Vuddandareddyprathap/Hardware-Implementation-of-Multiplication-Through-Repeated-Addition/constr/constrs.xdc

# 50 MHz Onboard PL Crystal Clock
set_property PACKAGE_PIN U18 [get_ports clk]
set_property IOSTANDARD LVCMOS33 [get_ports clk]
create_clock -period 20.000 -name sys_clk [get_ports clk]

# PL Push Buttons (Active-High)
# SW5 -> Reset Button
set_property PACKAGE_PIN V15 [get_ports rst_btn]
set_property IOSTANDARD LVCMOS33 [get_ports rst_btn]

# SW7 -> Manual Clock Step Button
set_property PACKAGE_PIN W15 [get_ports clk_step_btn]
set_property IOSTANDARD LVCMOS33 [get_ports clk_step_btn]

# 4 Slide Switches (sw[0] = SW3, sw[1] = SW4, sw[2] = SW6, sw[3] = SW8)
set_property PACKAGE_PIN W19 [get_ports {sw[0]}]
set_property IOSTANDARD LVCMOS33 [get_ports {sw[0]}]

set_property PACKAGE_PIN N17 [get_ports {sw[1]}]
set_property IOSTANDARD LVCMOS33 [get_ports {sw[1]}]

set_property PACKAGE_PIN P18 [get_ports {sw[2]}]
set_property IOSTANDARD LVCMOS33 [get_ports {sw[2]}]

set_property PACKAGE_PIN P15 [get_ports {sw[3]}]
set_property IOSTANDARD LVCMOS33 [get_ports {sw[3]}]

# 4 Onboard User LEDs (D4 - D7)
set_property PACKAGE_PIN R16 [get_ports {led[0]}]
set_property IOSTANDARD LVCMOS33 [get_ports {led[0]}]

set_property PACKAGE_PIN R17 [get_ports {led[1]}]
set_property IOSTANDARD LVCMOS33 [get_ports {led[1]}]

set_property PACKAGE_PIN T17 [get_ports {led[2]}]
set_property IOSTANDARD LVCMOS33 [get_ports {led[2]}]

set_property PACKAGE_PIN R18 [get_ports {led[3]}]
set_property IOSTANDARD LVCMOS33 [get_ports {led[3]}]

# 4-Digit 7-Segment Display Anodes (Active-High through BC847 Transistors)
# an[0]=DIGIT4(right), an[1]=DIGIT3, an[2]=DIGIT2, an[3]=DIGIT1(left)
set_property PACKAGE_PIN U12 [get_ports {an[0]}]
set_property IOSTANDARD LVCMOS33 [get_ports {an[0]}]

set_property PACKAGE_PIN T12 [get_ports {an[1]}]
set_property IOSTANDARD LVCMOS33 [get_ports {an[1]}]

set_property PACKAGE_PIN T10 [get_ports {an[2]}]
set_property IOSTANDARD LVCMOS33 [get_ports {an[2]}]

set_property PACKAGE_PIN T11 [get_ports {an[3]}]
set_property IOSTANDARD LVCMOS33 [get_ports {an[3]}]

# 7-Segment Display Cathodes a-g + DP (Active-Low)
set_property PACKAGE_PIN V13 [get_ports {seg[0]}]
set_property IOSTANDARD LVCMOS33 [get_ports {seg[0]}]

set_property PACKAGE_PIN V12 [get_ports {seg[1]}]
set_property IOSTANDARD LVCMOS33 [get_ports {seg[1]}]

set_property PACKAGE_PIN W13 [get_ports {seg[2]}]
set_property IOSTANDARD LVCMOS33 [get_ports {seg[2]}]

set_property PACKAGE_PIN T14 [get_ports {seg[3]}]
set_property IOSTANDARD LVCMOS33 [get_ports {seg[3]}]

set_property PACKAGE_PIN T15 [get_ports {seg[4]}]
set_property IOSTANDARD LVCMOS33 [get_ports {seg[4]}]

set_property PACKAGE_PIN P14 [get_ports {seg[5]}]
set_property IOSTANDARD LVCMOS33 [get_ports {seg[5]}]

set_property PACKAGE_PIN R14 [get_ports {seg[6]}]
set_property IOSTANDARD LVCMOS33 [get_ports {seg[6]}]

set_property PACKAGE_PIN Y16 [get_ports dp]
set_property IOSTANDARD LVCMOS33 [get_ports dp]

# Clock routing overrides for button pulse clocking
set_property CLOCK_DEDICATED_ROUTE FALSE [get_nets step_pulse]
